Hassan2203/System-On-Chip-SOC-Design-and-verification/(commit log)

2026-06-19 Update print statement from 'Hello' to 'Goodbye'
2026-06-19 README
    Added image and updated FPGA pin usage section.
